Lymkin/ESP8226_Garage_Controller/info/Complete PCB Top.jpg

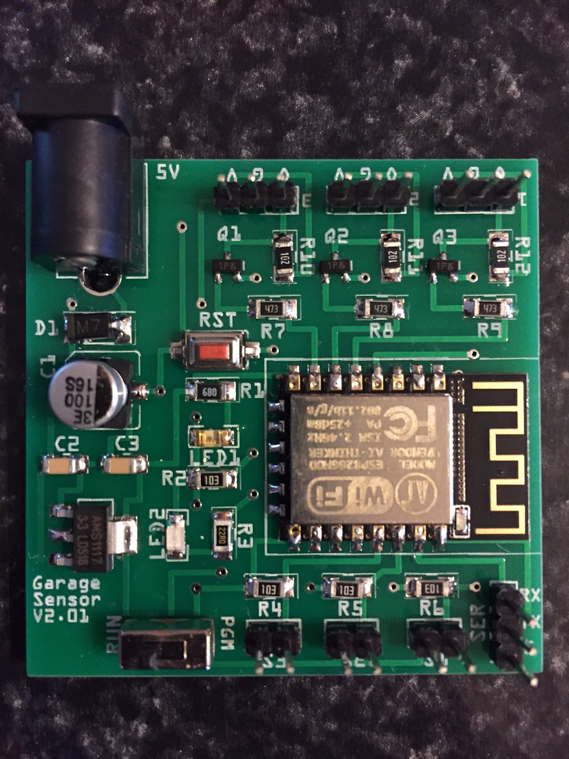
info/Complete PCB Top.jpg
