Lymkin/ESP8226_Garage_Controller/info/DoorsClosed.PNG

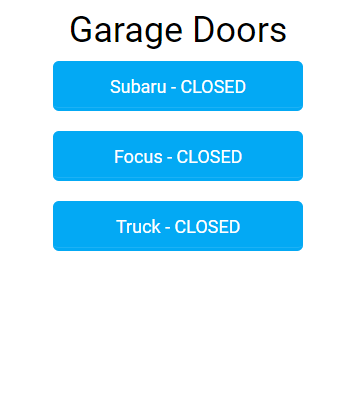
info/DoorsClosed.PNG
