Lymkin/ESP8226_Garage_Controller/info/FileBrowser.PNG

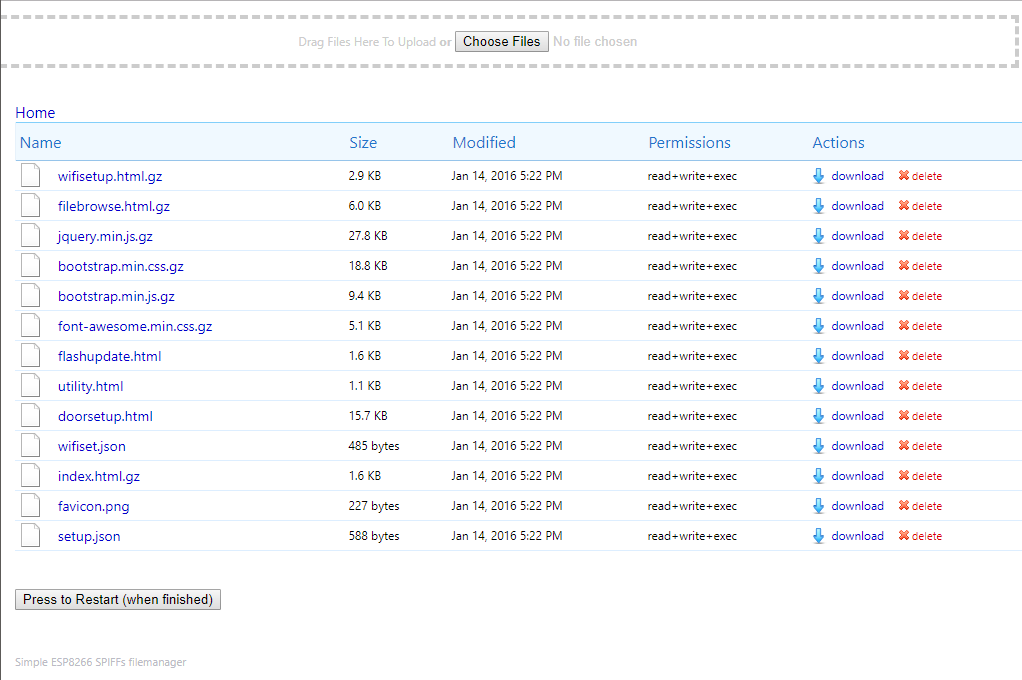
info/FileBrowser.PNG
