Lymkin/ESP8226_Garage_Controller/info/DoorSetup.PNG

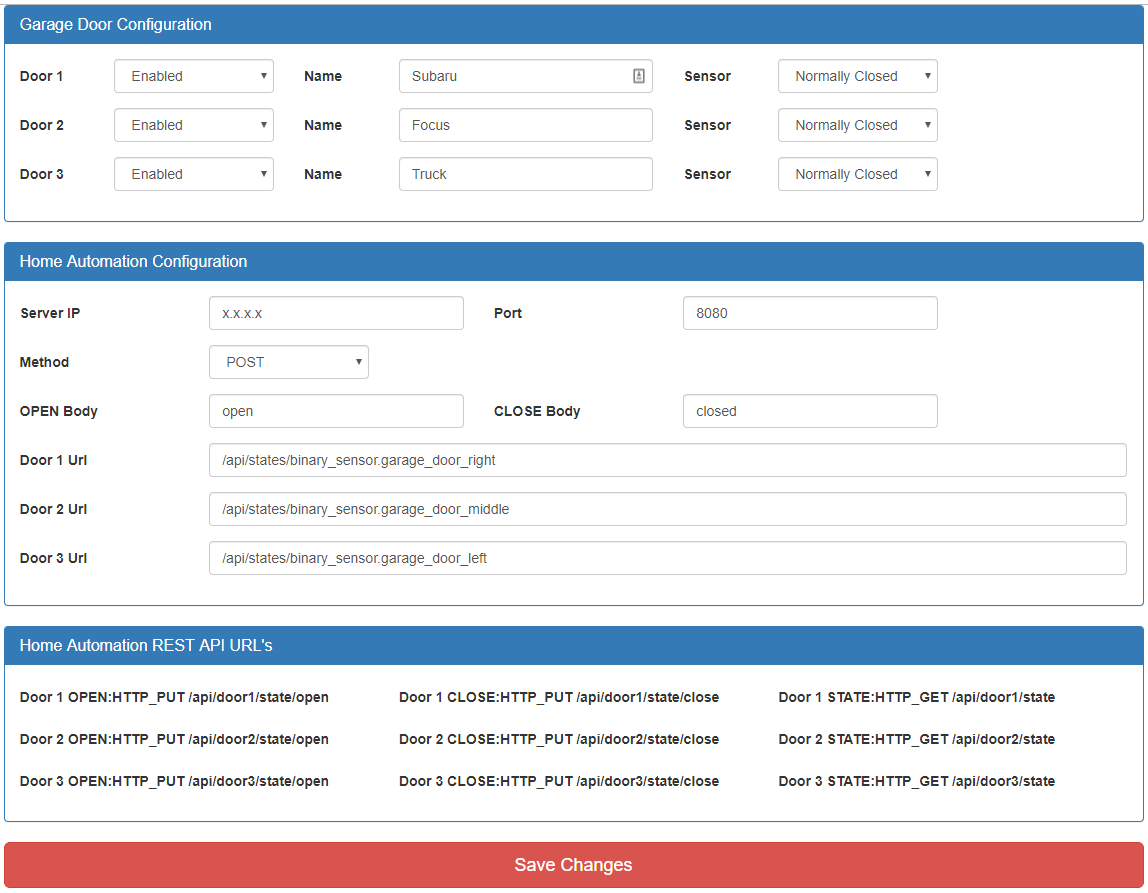
info/DoorSetup.PNG
