Lymkin/ESP8226_Garage_Controller/info/WiFiSetup.PNG

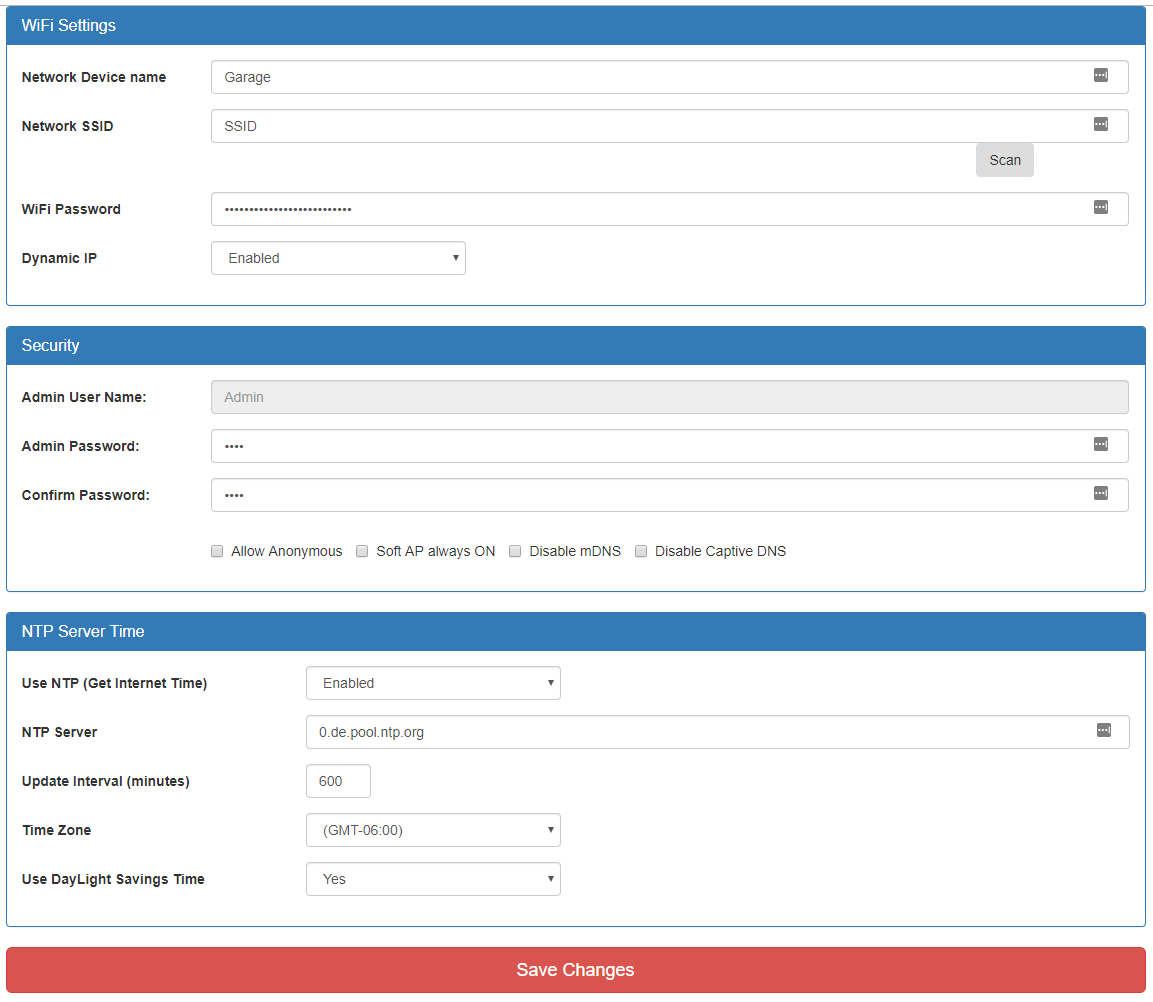
info/WiFiSetup.PNG
