Lymkin/ESP8226_Garage_Controller/info/Wiring Diagram.jpg

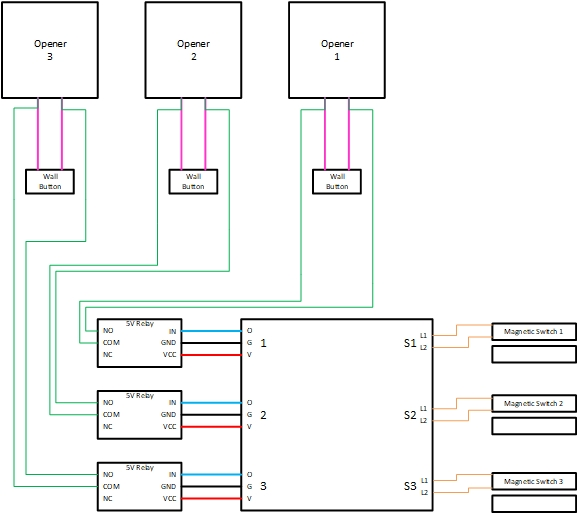
info/Wiring Diagram.jpg
